joeferner/stm32-debug-breakout/stm32-debug-breakout.kicad_pcb

## KiCad design stm32-debug-breakout.kicad_pcb (2021-10-24)

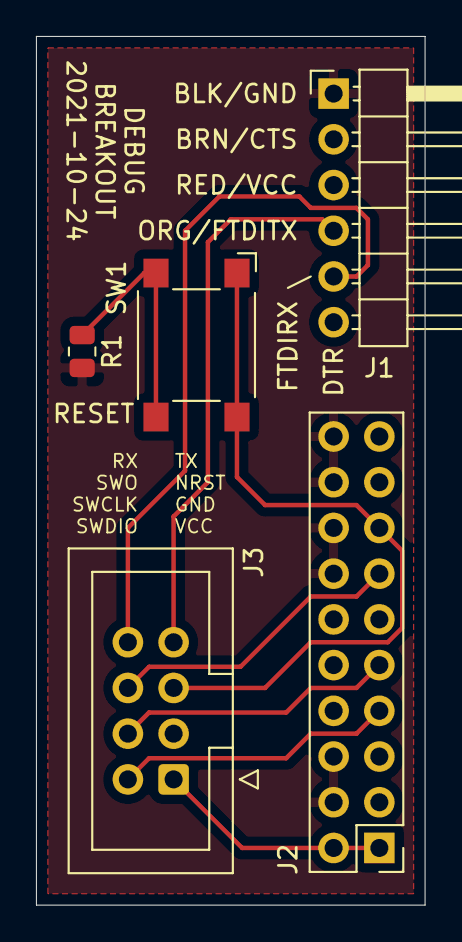
[picture p1: board stm32-debug-breakout.kicad_pcb from above]

Board: 2 copper layers, 21.6 x 48.3 mm, 5 parts (0 on the bottom side), 9 nets.

Parts:
J1: FTDI; PinHeader_1x06_P2.54mm_Horizontal
J2: STLINK; PinHeader_2x10_P2.54mm_Vertical
J3: ST_PROGRAM_DEBUG; IDC-Header_2x04_P2.54mm_Vertical
R1: 0R; R_0805_2012Metric
SW1: SW_MEC_5E; SW_SPST_Omron_B3FS-100xP

Connections:
/NRST: J2.15, J3.5, SW1.1, SW1.2
/RX: J1.5, J3.8
/SWCLK: J2.9, J3.4
/SWDIO: J2.7, J3.2
/SWO: J2.13, J3.6
/TX: J1.4, J3.7
GND: J1.1, J2.4, J2.6, J2.8, J2.10, J2.12, J2.14, J2.16, J2.18, J2.20, J3.3, R1.2
unnamed: R1.1, SW1.3, SW1.4
VCC: J2.1, J2.2, J3.1
